retrospy/disco-cart/cartridge/PCBWay_BOM.xlsx

 |  |  | xxxx xxxx xxxxx xxPCS BOM (Sample Bill of Materials)
Item # | *Designator | *Qty | Manufacturer | *Mfg Part # | Description / Value | *Package/Footprint | Type | Your Instructions / Notes
1 | C3,C4,C5,C9,C10,C11 | 6 | KYOCERA AVX | KGM21NR71H104KM | CAP CER 0.1UF 50V X7R 0805 | 0805 | SMD
2 | C1,C8 | 2 | Samsung Electro-Mechanics | CL21B105KAFNNNE | CAP CER 1UF 25V X7R 0805 | 0805 | SMD
3 | C6 | 1 | Samsung Electro-Mechanics | CL21A106KOCLRNC | CAP CER 10UF 16V X5R 0805 | 0805 | SMD
4 | D1 | 1 | Nexperia USA Inc. | PMEG2005CT,215 | DIODE ARRAY SCHOTTKY 20V | SOT23 | SMD
5 | D2 | 1 | onsemi | MMBD717LT1G | DIODE ARRAY SCHOTTKY 20V SC70-3 | SOT-323 | SMD
6 | R1,R2,R3,R4,R5,R6,R7,R8,R9 | 9 | YAGEO | RC0805JR-0710KL | RES 10K OHM 5% 1/8W 0805 | 0805 | SMD
7 | SW2 | 1 | Nidec Components Corporation | CL-SB-13B-01T | SWITCH SLIDE SP3T 200MA 12V | SP3T | SMD
8 | U2 | 1 | Texas Instruments | SN74CBTLV3125PW | IC BUS SWITCH 1 X 1:1 14TSSOP | 14TSSOP | SMD
9 | U3 | 1 | Microchip Technology | SST39VF6401B-70-4I-EKE-T | IC FLASH 64MBIT PARALLEL 48TSOP | 48TSOP | SMD
Need a quick and accurante quote? Need an efficient production? Please read SMT Ordering Necessary Files & Info in 1 minute. Thank you very much! (https://www.pcbway.com/smt_ordering_guide.html)
Click for Instructions on How to Create a BOM (https://www.pcbway.com/blog/PCB_Assembly/How_to_Build_a_BOM__Bill_Of_Materials_.html)
