retrospy/disco-cart/cartridge/Disco-Cart-3e/Disco-Cart-3e_BOM_2024-07-28.xlsx

 |  |  | xxxx xxxx xxxxx xxPCS BOM (Sample Bill of Materials)
Item # | *Designator | *Qty | Manufacturer | *Mfg Part # | Description / Value | *Package/Footprint | Type | Your Instructions / Notes
1 | C1,C8 | 2 | Samsung Electro-Mechanics | CL21B105KAFNNNE | CAP CER 1UF 25V X7R 0805 | 0805 | SMD
2 | C2,C4,C5,C9,C10,C11 | 6 | KYOCERA AVX | KGM21NR71H104KT | CAP CER 0.1UF 50V X7R 0805 | 0805 | SMD
3 | C3,C7,C27,C28,C30,C31,C32,C33,C34,C35,C36,C40 | 12 | Murata | GRM155R71E104KE14J | CAP CER 0.1UF 25V X7R 0402 | 0402 | SMD
4 | C29,C37 | 2 | Murata | GRM155C81A105KA12D | CAP CER 1UF 10V X6S 0402 | 0402 | SMD
5 | C6,C38,C39,C41 | 4 | Murata | GRM21BR61C106KE15K | CAP CER 10UF 16V X5R 0805 | 0805 | SMD
6 | C42,C43 | 2 | Murata | GCM1555C1H150JA16D | CAP CER 15PF 50V C0G/NP0 0402 | 0402 | SMD
7 | D1 | 1 | Nexperia USA Inc. | PMEG2005CT,215 | DIODE ARR SCHOTT 20V TO236AB | SOT23 | SMD
8 | D2 | 1 | onsemi | MMBD717LT1G | DIODE ARRAY SCHOTT 20V SC70-3 | SOT-323 | SMD
9 | IC1 | 1 | Texas Instruments | SN74CBTLV3125PWR | Digital Bus Switch ICs Quad FET Low V | 14-TSSOP | SMD
10 | IC2 | 1 | Micron Technology Inc. | MT28EW01GABA1HJS-0SIT | IC FLASH 1GBIT PARALLEL 56TSOP | 56-TSOP | SMD
11 | IC4 | 1 | Raspberry Pi | SC0914 (13) | IC MCU 32BIT EXT MEM 56QFN | 56QFN | SMD
12 | IC6, IC7 | 2 | Texas Instruments | SN74HC373PWR | IC D-TYPE TRANSP SGL 8:8 20TSSOP | 20TSSOP | SMD
13 | J1 | 1 | Amphenol ICC (FCI) | 10118194-0001LF | CONN RCPT USB2.0 MICRO B SMD R/A |  | SMD
14 | R1,R2,R3,R4,R5,R6,R7,R8,R9,R10,R11,R12,R13,R14 | 14 | Stackpole Electronics Inc | RMCF0805JT10K0 | RES 10K OHM 5% 1/8W 0805 | 0805 | SMD
15 | R15, R16 | 2 | Stackpole Electronics Inc | RMCF0603ZT0R00 | RES 0 OHM JUMPER 1/10W 0603 | 0603 | SMD
16 | R17 | 1 | Yageo | RC0805FR-071KL | RES 1K OHM 1% 1/8W 0805 | 0805 | SMD
17 | R19,R22 | 2 | Yageo | RC0402FR-071KP | RES SMD 1K OHM 1% 1/16W 0402 | 0402 | SMD
18 | R20,R21 | 2 | Yageo | RC0402FR-0727R4L | RES SMD 27.4 OHM 1% 1/16W 0402 | 0402 | SMD
19 | U4 | 1 | Winbond | W25Q16JVSSIQ TR | IC FLASH 16MBIT SPI/QUAD 8SOIC | SOIC-8 | SMD
20 | U3 | 1 | ON Semiconductor | NCP1117ST33T3G | IC REG LINEAR 3.3V 1A SOT223 | SOT-223-3 | SMD
21 | Y2 | 1 | Abracon | ABM8G-12.000MHZ-4Y-T3 | CRYSTAL 12.0000MHZ 10PF SMD | SMD_3225 | SMD
Need a quick and accurante quote? Need an efficient production? Please read SMT Ordering Necessary Files & Info in 1 minute. Thank you very much! (https://www.pcbway.com/smt_ordering_guide.html)
Click for Instructions on How to Create a BOM (https://www.pcbway.com/blog/PCB_Assembly/How_to_Build_a_BOM__Bill_Of_Materials_.html)
