retrospy/disco-cart/cartridge/Disco-Cart-3e/Disco-Cart-3e-Schematic-1.pdf

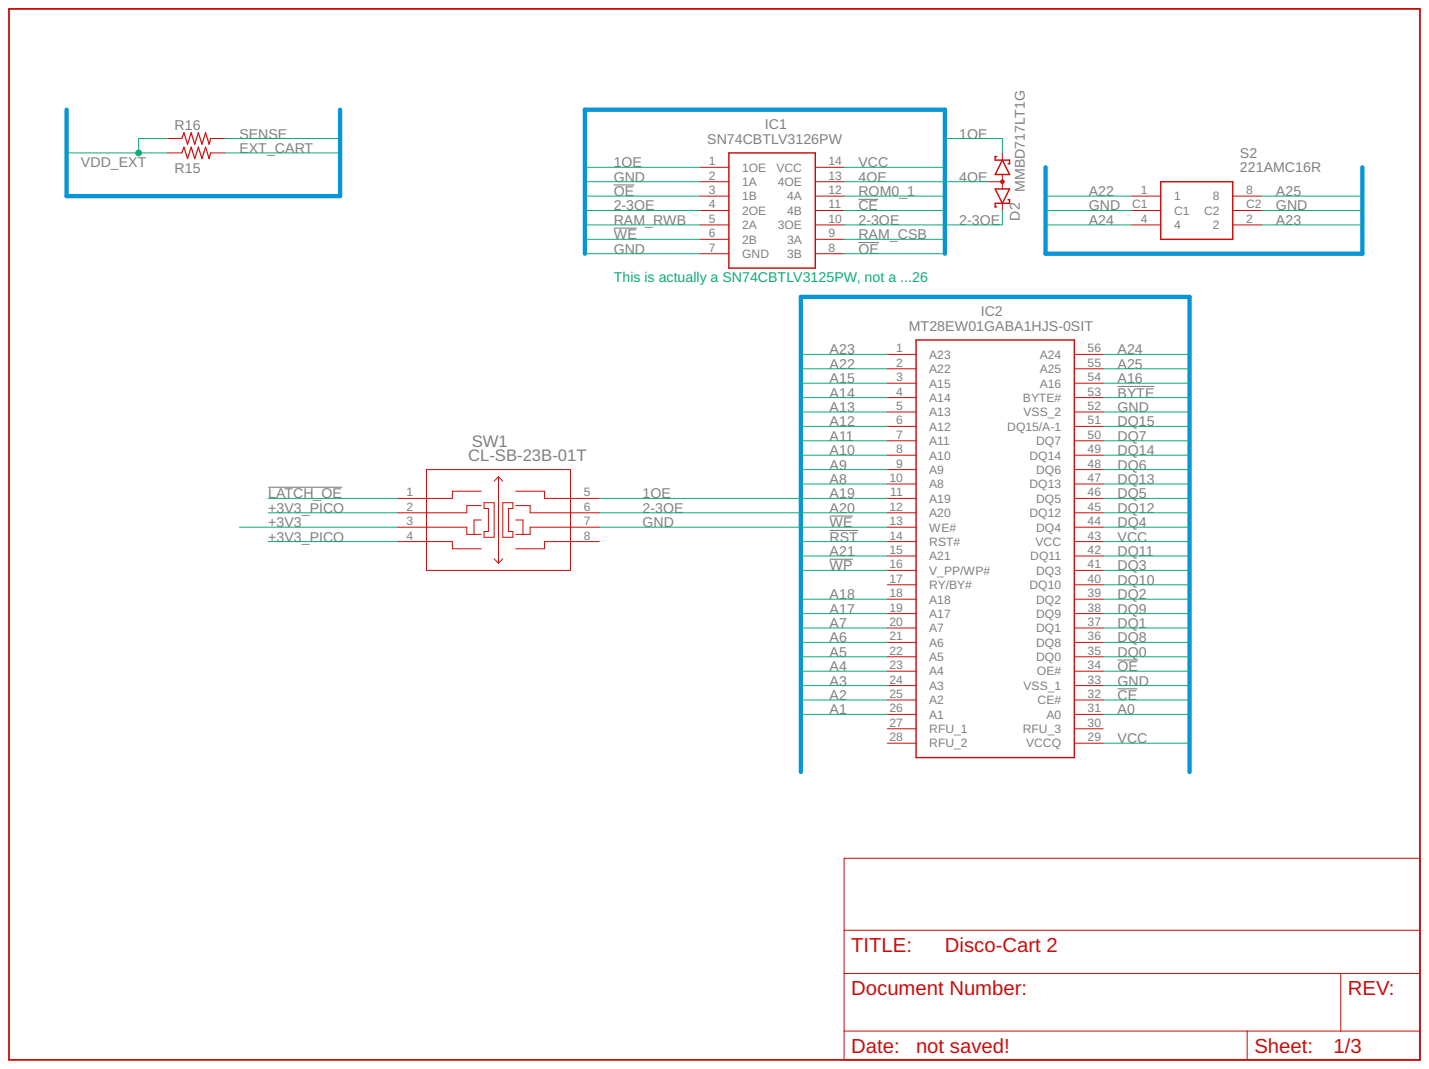
[picture p1: page 1]

This is actually a SN74CBTLV3125PW, not a ...26

A22 | 55 A16 A25
A14 | 54 BYTE# BYTE
A15 | A16
A13 | 53 VSS_2 GND
A12 | 52 DQ15/A-1 51 DQ7 DQ15

A11 | 50 DQ14 DQ7
A9 | 49 DQ6 DQ6
A10 | DQ14
A8 | 48 DQ13 DQ13
A19 A20 WE RST | 47 DQ5 46 DQ12 DQ5

A21 | 43 DQ11 DQ11
WP | 42 DQ3 41 DQ10 DQ3

A18 | 40 DQ2 DQ10
A17 | 39 DQ9 DQ9
A7 | 38 DQ1 DQ1
A6 | 37 DQ8 36 DQ0 DQ8

A5 | 35 OE# DQ0
A3 | 34 VSS_1 GND
A4 | OE
A2 | 33 CE# CE
A1 | 32 A0 31 RFU_3 A0

Document Number: | REV:

Date: not saved! | Sheet: 1/3
