retrospy/disco-cart/cartridge/Disco-Cart-3e/Disco-Cart-3e-Schematic-2.pdf

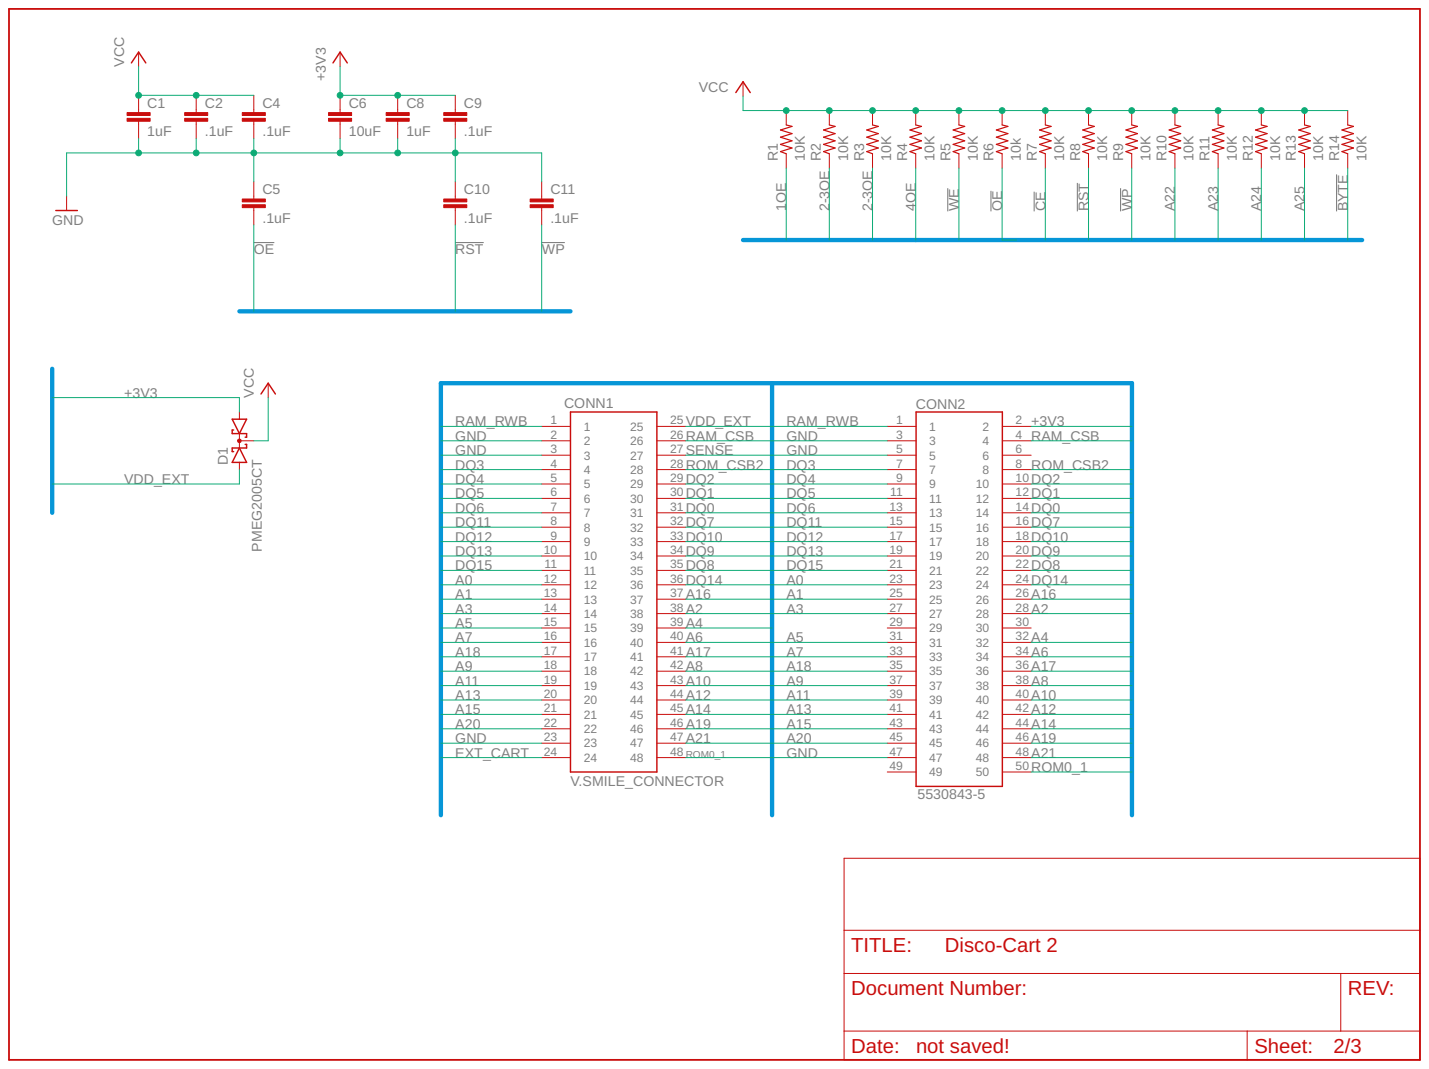
[picture p2: page 1]

GND 2 | 26 RAM_CSB | GND 3 | 4 RAM_CSB
GND 3 | 27 SENSE | GND 5 | 6 ROM_CSB2
DQ3 4 | 28 ROM_CSB2 | DQ3 7 | 8
DQ4 5 | 29 DQ2 | DQ4 9 | 10 DQ2
DQ5 6 | 30 DQ1 | DQ5 11 | 12 DQ1
DQ6 7 | 31 DQ0 | DQ6 13 | 14 DQ0
DQ11 8 | 32 DQ7 | DQ11 15 | 16 DQ7
DQ12 9 | 33 DQ10 | DQ12 17 | 18 DQ10
DQ13 10 | 34 DQ9 | DQ13 19 | 20 DQ9
DQ15 11 | 35 DQ8 | DQ15 21 | 22 DQ8
A0 12 | 36 DQ14 | A0 23 | 24 DQ14
A1 13 | 37 A16 | A1 25 | 26 A16
A3 14 | 38 A2 | A3 27 | 28 A2
A5 15 | 39 A4 | 29 A5 31 | 30 A4

A18 17 | 41 A17 | A7 33 | 34 A6
A9 18 | 42 A8 | A18 35 | 36 A17
A11 19 | 43 A10 | A9 37 | 38 A8
A13 20 | 44 A12 | A11 39 | 40 A10
A15 21 | 45 A14 | A13 41 | 42 A12
A20 22 | 46 A19 | A15 43 | 44 A14
GND 23 | 47 A21 | A20 45 | 46 A19
EXT_CART 24 | 48 | GND 47 | 48 A21

Document Number: | REV:

Date: not saved! | Sheet: 2/3
