retrospy/disco-cart/cartridge/Disco-Cart-3e/Disco-Cart-3e-Schematic-3.pdf

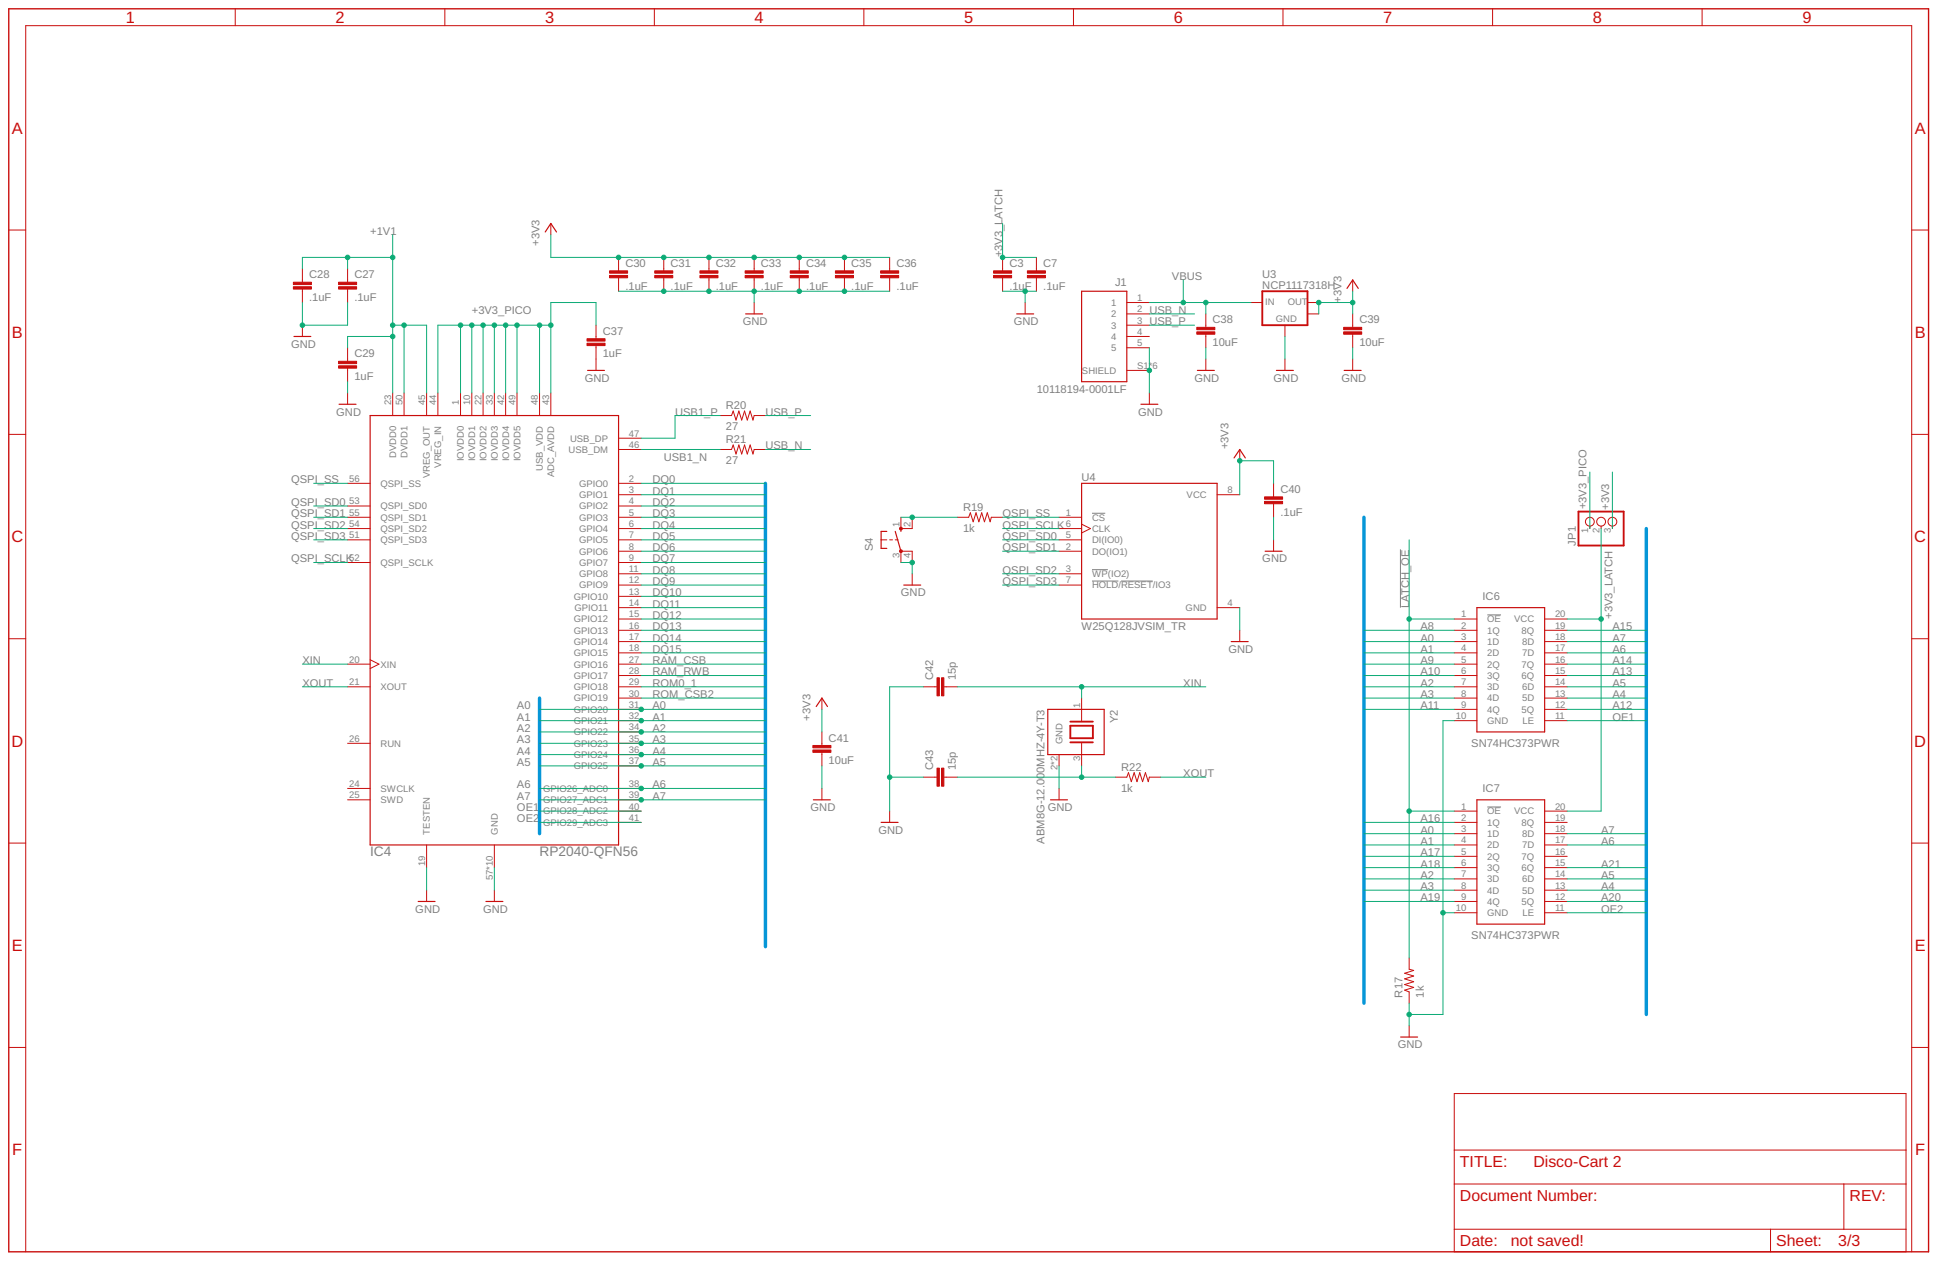
[picture p3: page 1]

36 GPIO25

37 GPIO26_ADC0 38 GPIO27_ADC1

A16 | 2 | | 19 18
A0 | 3
A1 | 4 | | 17 A6

A18 | 6
A2 | 7 | 14 A5
A3 | 8 | 13 A4

Document Number: | REV:

Date: not saved! | Sheet: 3/3
