retrospy/disco-cart/cartridge/Disco-Cart-3e/EAGLE/Disco-Cart 2.brd

## EAGLE design cartridge/Disco-Cart-3e/EAGLE/Disco-Cart 2.brd (2024-10-04)

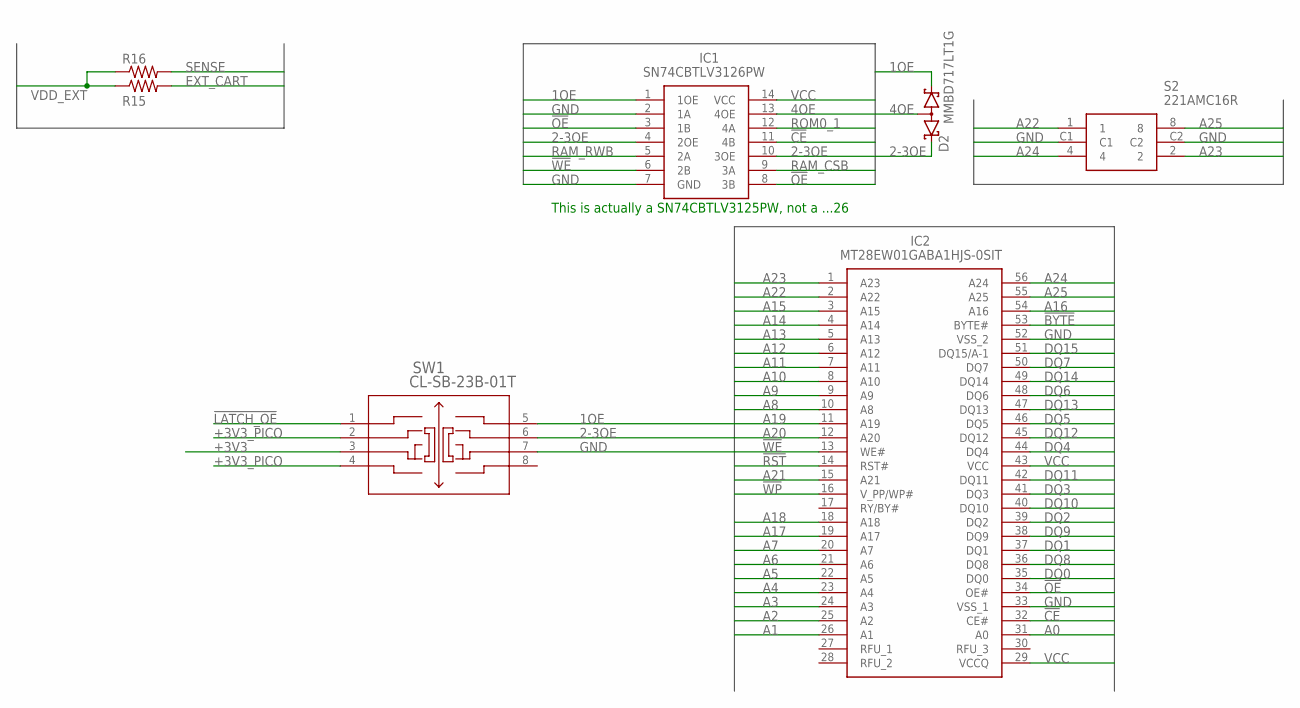
[picture p4: schematic Disco-Cart 2.sch, sheet 1]

Parts:
D2: MMBD717LT1G; SOT65P220X100-3N
IC1: SN74CBTLV3126PW; SOP65P640X120-14N
IC2: MT28EW01GABA1HJS-0SIT; SOP50P2000X120-56N
R15, R16: R-US_R0603; R0603
S2: 221AMC16R
SW1: CL-SB-23B-01T; CL-SB-23B_NDC

Connections:
1OE: D2.1 (K2), IC1.1 (1OE), SW1.5 (8); also elsewhere on the board
2-3OE: D2.2 (K1), IC1.4 (2OE), IC1.10 (3OE), SW1.6 (7); also elsewhere on the board
4OE: D2.3 (AA), IC1.13 (4OE); also elsewhere on the board
!BYTE: IC2.53 (BYTE#); also elsewhere on the board
!CE: IC1.11 (4B), IC2.32 (CE#); also elsewhere on the board
!LATCH_OE: SW1.1; also elsewhere on the board
!OE: IC1.3 (1B), IC1.8 (3B), IC2.34 (OE#); also elsewhere on the board
!RST: IC2.14 (RST#); also elsewhere on the board
!WE: IC1.6 (2B), IC2.13 (WE#); also elsewhere on the board
!WP: IC2.16 (V_PP/WP#); also elsewhere on the board
+3V3: SW1.3; also elsewhere on the board
+3V3_PICO: SW1.2, SW1.4; also elsewhere on the board
A0: IC2.31 (A0); also elsewhere on the board
A1: IC2.26 (A1); also elsewhere on the board
A2: IC2.25 (A2); also elsewhere on the board
A3: IC2.24 (A3); also elsewhere on the board
A4: IC2.23 (A4); also elsewhere on the board
A5: IC2.22 (A5); also elsewhere on the board
A6: IC2.21 (A6); also elsewhere on the board
A7: IC2.20 (A7); also elsewhere on the board
A8: IC2.10 (A8); also elsewhere on the board
A9: IC2.9 (A9); also elsewhere on the board
A10: IC2.8 (A10); also elsewhere on the board
A11: IC2.7 (A11); also elsewhere on the board
A12: IC2.6 (A12); also elsewhere on the board
A13: IC2.5 (A13); also elsewhere on the board
A14: IC2.4 (A14); also elsewhere on the board
A15: IC2.3 (A15); also elsewhere on the board
A16: IC2.54 (A16); also elsewhere on the board
A17: IC2.19 (A17); also elsewhere on the board
A18: IC2.18 (A18); also elsewhere on the board
A19: IC2.11 (A19); also elsewhere on the board
A20: IC2.12 (A20); also elsewhere on the board
A21: IC2.15 (A21); also elsewhere on the board
A22: IC2.2 (A22), S2.1; also elsewhere on the board
A23: IC2.1 (A23), S2.2; also elsewhere on the board
A24: IC2.56 (A24), S2.4; also elsewhere on the board
A25: IC2.55 (A25), S2.8; also elsewhere on the board
DQ0: IC2.35 (DQ0); also elsewhere on the board
DQ1: IC2.37 (DQ1); also elsewhere on the board
DQ2: IC2.39 (DQ2); also elsewhere on the board
DQ3: IC2.41 (DQ3); also elsewhere on the board
DQ4: IC2.44 (DQ4); also elsewhere on the board
DQ5: IC2.46 (DQ5); also elsewhere on the board
DQ6: IC2.48 (DQ6); also elsewhere on the board
DQ7: IC2.50 (DQ7); also elsewhere on the board
DQ8: IC2.36 (DQ8); also elsewhere on the board
DQ9: IC2.38 (DQ9); also elsewhere on the board
DQ10: IC2.40 (DQ10); also elsewhere on the board
DQ11: IC2.42 (DQ11); also elsewhere on the board
DQ12: IC2.45 (DQ12); also elsewhere on the board
DQ13: IC2.47 (DQ13); also elsewhere on the board
DQ14: IC2.49 (DQ14); also elsewhere on the board
DQ15: IC2.51 (DQ15/A-1); also elsewhere on the board
EXT_CART: R15.2; also elsewhere on the board
GND: IC1.2 (1A), IC1.7 (GND), IC2.33 (VSS_1), IC2.52 (VSS_2), S2.C1, S2.C2, SW1.7 (6); also elsewhere on the board
RAM_CSB: IC1.9 (3A); also elsewhere on the board
RAM_RWB: IC1.5 (2A); also elsewhere on the board
ROM0_1: IC1.12 (4A); also elsewhere on the board
SENSE: R16.2; also elsewhere on the board
VCC: IC1.14 (VCC), IC2.29 (VCCQ), IC2.43 (VCC); also elsewhere on the board
VDD_EXT: R15.1, R16.1; also elsewhere on the board

Notes on the sheet:
This is actually a SN74CBTLV3125PW, not a ...26

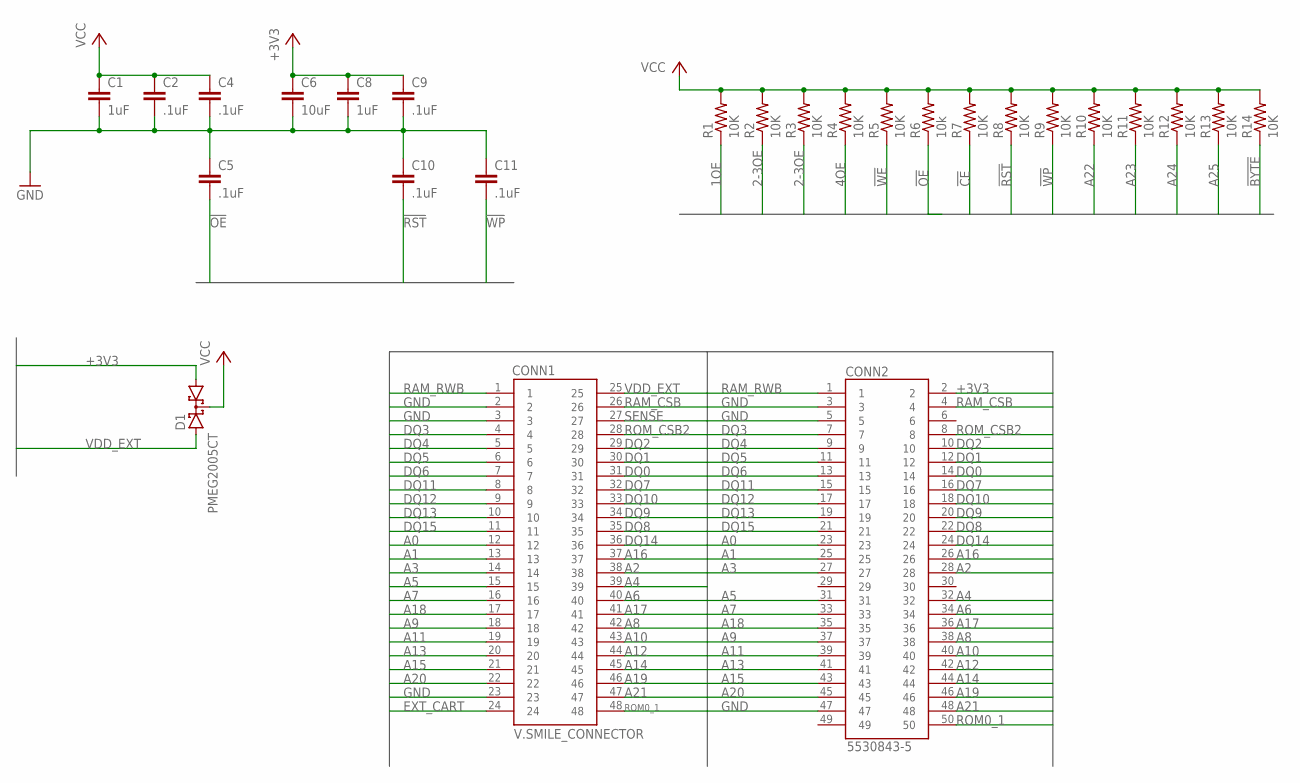
[picture p5: schematic Disco-Cart 2.sch, sheet 2]

Parts:
C1, C8: 1uF; C0805
C2, C4, C5, C9, C10, C11: .1uF; C0805
C6: 10uF; C0805
CONN1: V.SMILE_CONNECTOR
CONN2: 5530843-5; TE_5530843-5
D1: PMEG2005CT; SOT23
R1, R2, R3, R4, R5, R7, R8, R9, R10, R11, R12, R13, R14: 10K; M0805
R6: 10k; M0805

Connections:
1OE: R1.1; also elsewhere on the board
2-3OE: R2.1, R3.1; also elsewhere on the board
4OE: R4.1; also elsewhere on the board
!BYTE: R14.1; also elsewhere on the board
!CE: R7.1; also elsewhere on the board
!OE: C5.2, R6.1; also elsewhere on the board
!RST: C10.2, R8.1; also elsewhere on the board
!WE: R5.1; also elsewhere on the board
!WP: C11.2, R9.1; also elsewhere on the board
+3V3: C6.1, C8.1, C9.1, CONN2.2, D1.1 (A1); also elsewhere on the board
A0: CONN1.12, CONN2.23; also elsewhere on the board
A1: CONN1.13, CONN2.25; also elsewhere on the board
A2: CONN1.38, CONN2.28; also elsewhere on the board
A3: CONN1.14, CONN2.27; also elsewhere on the board
A4: CONN1.39, CONN2.32; also elsewhere on the board
A5: CONN1.15, CONN2.31; also elsewhere on the board
A6: CONN1.40, CONN2.34; also elsewhere on the board
A7: CONN1.16, CONN2.33; also elsewhere on the board
A8: CONN1.42, CONN2.38; also elsewhere on the board
A9: CONN1.18, CONN2.37; also elsewhere on the board
A10: CONN1.43, CONN2.40; also elsewhere on the board
A11: CONN1.19, CONN2.39; also elsewhere on the board
A12: CONN1.44, CONN2.42; also elsewhere on the board
A13: CONN1.20, CONN2.41; also elsewhere on the board
A14: CONN1.45, CONN2.44; also elsewhere on the board
A15: CONN1.21, CONN2.43; also elsewhere on the board
A16: CONN1.37, CONN2.26; also elsewhere on the board
A17: CONN1.41, CONN2.36; also elsewhere on the board
A18: CONN1.17, CONN2.35; also elsewhere on the board
A19: CONN1.46, CONN2.46; also elsewhere on the board
A20: CONN1.22, CONN2.45; also elsewhere on the board
A21: CONN1.47, CONN2.48; also elsewhere on the board
A22: R10.1; also elsewhere on the board
A23: R11.1; also elsewhere on the board
A24: R12.1; also elsewhere on the board
A25: R13.1; also elsewhere on the board
DQ0: CONN1.31, CONN2.14; also elsewhere on the board
DQ1: CONN1.30, CONN2.12; also elsewhere on the board
DQ2: CONN1.29, CONN2.10; also elsewhere on the board
DQ3: CONN1.4, CONN2.7; also elsewhere on the board
DQ4: CONN1.5, CONN2.9; also elsewhere on the board
DQ5: CONN1.6, CONN2.11; also elsewhere on the board
DQ6: CONN1.7, CONN2.13; also elsewhere on the board
DQ7: CONN1.32, CONN2.16; also elsewhere on the board
DQ8: CONN1.35, CONN2.22; also elsewhere on the board
DQ9: CONN1.34, CONN2.20; also elsewhere on the board
DQ10: CONN1.33, CONN2.18; also elsewhere on the board
DQ11: CONN1.8, CONN2.15; also elsewhere on the board
DQ12: CONN1.9, CONN2.17; also elsewhere on the board
DQ13: CONN1.10, CONN2.19; also elsewhere on the board
DQ14: CONN1.36, CONN2.24; also elsewhere on the board
DQ15: CONN1.11, CONN2.21; also elsewhere on the board
EXT_CART: CONN1.24; also elsewhere on the board
GND: C1.2, C2.2, C4.2, C5.1, C6.2, C8.2, C9.2, C10.1, C11.1, CONN1.2, CONN1.3, CONN1.23, CONN2.3, CONN2.5, CONN2.47; also elsewhere on the board
RAM_CSB: CONN1.26, CONN2.4; also elsewhere on the board
RAM_RWB: CONN1.1, CONN2.1; also elsewhere on the board
ROM0_1: CONN1.48, CONN2.50; also elsewhere on the board
ROM_CSB2: CONN1.28, CONN2.8; also elsewhere on the board
SENSE: CONN1.27; also elsewhere on the board
VCC: C1.1, C2.1, C4.1, D1.3 (C), R1.2, R2.2, R3.2, R4.2, R5.2, R6.2, R7.2, R8.2, R9.2, R10.2, R11.2, R12.2, R13.2, R14.2; also elsewhere on the board
VDD_EXT: CONN1.25, D1.2 (A2); also elsewhere on the board

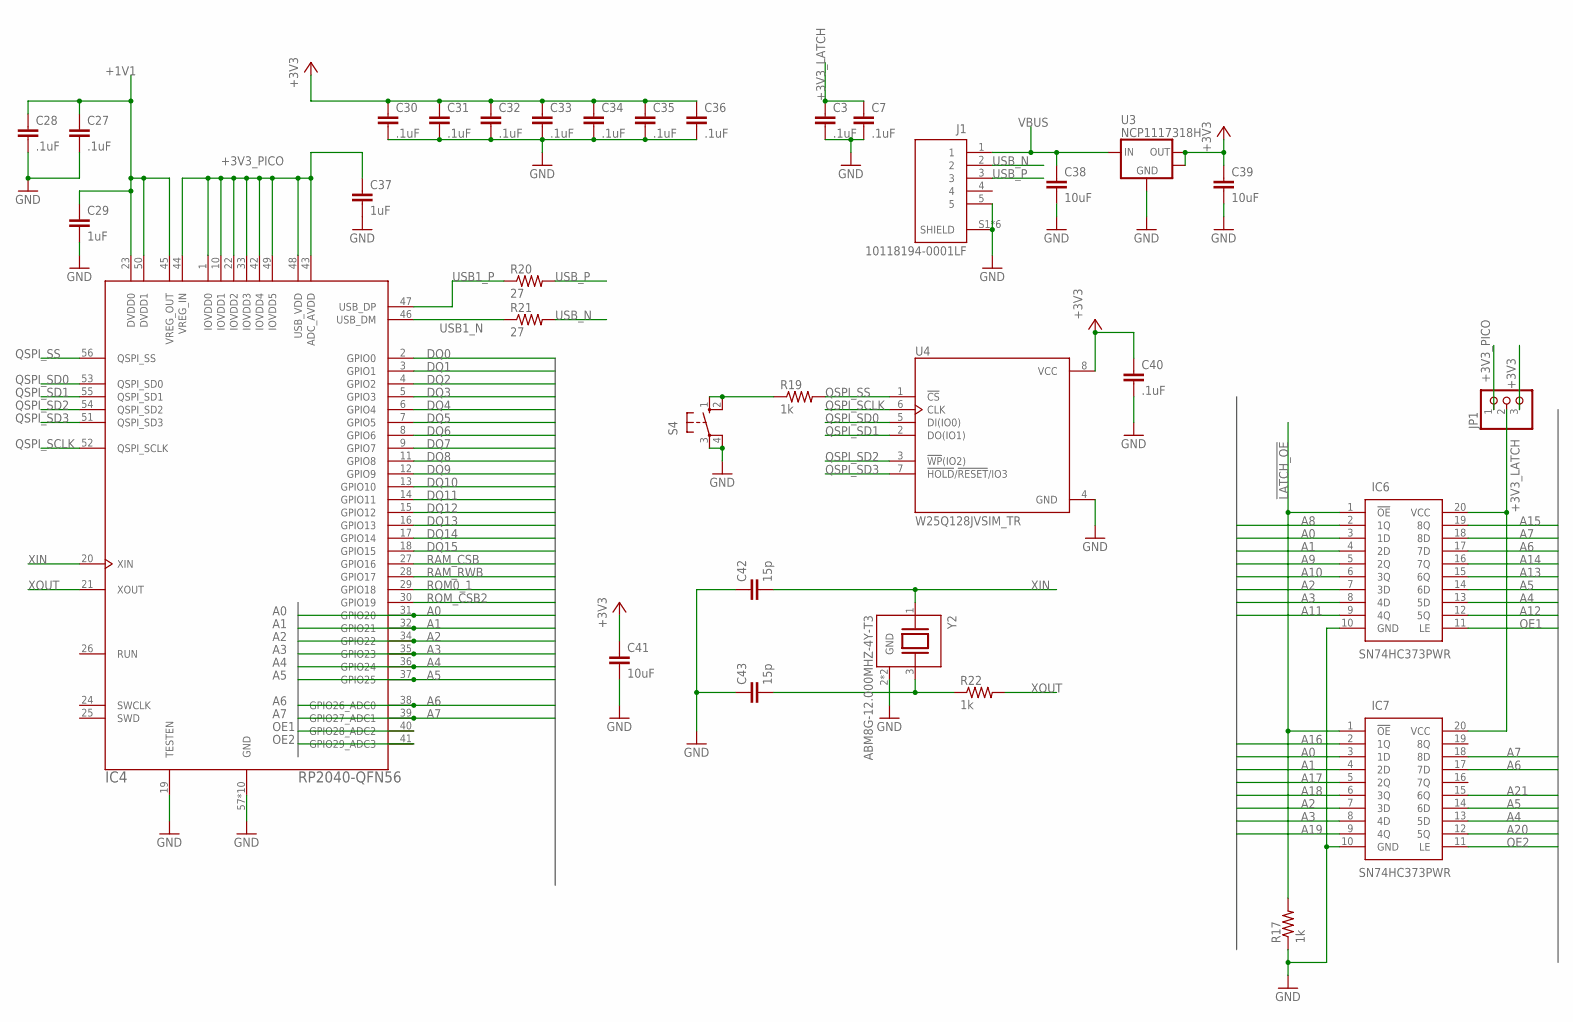
[picture p6: schematic Disco-Cart 2.sch, sheet 3]

Parts:
C3, C7, C27, C28, C30, C31, C32, C33, C34, C35, C36, C40: .1uF; C0402
C29, C37: 1uF; C0402
C38, C39, C41: 10uF; C0805
C42, C43: 15p; C0402
IC4: RP2040-QFN56; RP2040-QFN-56
IC6, IC7: SN74HC373PWR; SOP65P640X120-20N
J1: 10118194-0001LF; AMPHENOL_10118194-0001LF
JP1: PINHD-1X3; 1X03
R17: 1k; R0805
R19, R22: 1k; R0402
R20, R21: 27; R0402
S4: 10-XX; B3F-10XX
U3: NCP1117318H; SOT223
U4: W25Q128JVSIM_TR; SOIC127P790X216-8N
Y2: ABM8G-12.000MHZ-4Y-T3; XTAL_ABM8G-12.000MHZ-4Y-T3

Connections:
!LATCH_OE: IC6.1 (!OE), IC7.1 (!OE), R17.2; also elsewhere on the board
+1V1: C27.1, C28.1, C29.1, IC4.23 (DVDD0), IC4.45 (VREG_OUT), IC4.50 (DVDD1)
+3V3: C30.1, C31.1, C32.1, C33.1, C34.1, C35.1, C36.1, C39.1, C40.1, C41.1, JP1.3, U3.2 (OUT), U3.TAB (OUT), U4.8 (VCC); also elsewhere on the board
+3V3_LATCH: C3.1, C7.1, IC6.20 (VCC), IC7.20 (VCC), JP1.2
+3V3_PICO: C37.1, IC4.1 (IOVDD0), IC4.10 (IOVDD1), IC4.22 (IOVDD2), IC4.33 (IOVDD3), IC4.42 (IOVDD4), IC4.43 (ADC_AVDD), IC4.44 (VREG_IN), IC4.48 (USB_VDD), IC4.49 (IOVDD5), JP1.1; also elsewhere on the board
A0: IC4.31 (GPIO20), IC6.3 (1D), IC7.3 (1D); also elsewhere on the board
A1: IC4.32 (GPIO21), IC6.4 (2D), IC7.4 (2D); also elsewhere on the board
A2: IC4.34 (GPIO22), IC6.7 (3D), IC7.7 (3D); also elsewhere on the board
A3: IC4.35 (GPIO23), IC6.8 (4D), IC7.8 (4D); also elsewhere on the board
A4: IC4.36 (GPIO24), IC6.13 (5D), IC7.13 (5D); also elsewhere on the board
A5: IC4.37 (GPIO25), IC6.14 (6D), IC7.14 (6D); also elsewhere on the board
A6: IC4.38 (GPIO26_ADC0), IC6.17 (7D), IC7.17 (7D); also elsewhere on the board
A7: IC4.39 (GPIO27_ADC1), IC6.18 (8D), IC7.18 (8D); also elsewhere on the board
A8: IC6.2 (1Q); also elsewhere on the board
A9: IC6.5 (2Q); also elsewhere on the board
A10: IC6.6 (3Q); also elsewhere on the board
A11: IC6.9 (4Q); also elsewhere on the board
A12: IC6.12 (5Q); also elsewhere on the board
A13: IC6.15 (6Q); also elsewhere on the board
A14: IC6.16 (7Q); also elsewhere on the board
A15: IC6.19 (8Q); also elsewhere on the board
A16: IC7.2 (1Q); also elsewhere on the board
A17: IC7.5 (2Q); also elsewhere on the board
A18: IC7.6 (3Q); also elsewhere on the board
A19: IC7.9 (4Q); also elsewhere on the board
A20: IC7.12 (5Q); also elsewhere on the board
A21: IC7.15 (6Q); also elsewhere on the board
DQ0: IC4.2 (GPIO0); also elsewhere on the board
DQ1: IC4.3 (GPIO1); also elsewhere on the board
DQ2: IC4.4 (GPIO2); also elsewhere on the board
DQ3: IC4.5 (GPIO3); also elsewhere on the board
DQ4: IC4.6 (GPIO4); also elsewhere on the board
DQ5: IC4.7 (GPIO5); also elsewhere on the board
DQ6: IC4.8 (GPIO6); also elsewhere on the board
DQ7: IC4.9 (GPIO7); also elsewhere on the board
DQ8: IC4.11 (GPIO8); also elsewhere on the board
DQ9: IC4.12 (GPIO9); also elsewhere on the board
DQ10: IC4.13 (GPIO10); also elsewhere on the board
DQ11: IC4.14 (GPIO11); also elsewhere on the board
DQ12: IC4.15 (GPIO12); also elsewhere on the board
DQ13: IC4.16 (GPIO13); also elsewhere on the board
DQ14: IC4.17 (GPIO14); also elsewhere on the board
DQ15: IC4.18 (GPIO15); also elsewhere on the board
GND: C3.2, C7.2, C27.2, C28.2, C29.2, C30.2, C31.2, C32.2, C33.2, C34.2, C35.2, C36.2, C37.2, C38.2, C39.2, C40.2, C41.2, C42.1, C43.1, IC4.19 (TESTEN), IC4.57 (GND), IC4.58 (GND), IC4.59 (GND), IC4.60 (GND), IC4.61 (GND), IC4.62 (GND), IC4.63 (GND), IC4.64 (GND), IC4.65 (GND), IC4.66 (GND), IC6.10 (GND), IC7.10 (GND), J1.5, J1.S1 (SHIELD), J1.S2 (SHIELD), J1.S3 (SHIELD), J1.S4 (SHIELD), J1.S5 (SHIELD), J1.S6 (SHIELD), R17.1, S4.3, S4.4 (P1), U3.1 (GND), U4.4 (GND), Y2.2 (GND), Y2.4 (GND); also elsewhere on the board
unnamed: R19.1, S4.1 (S), S4.2 (S1)
OE1: IC4.40 (GPIO28_ADC2), IC6.11 (LE)
OE2: IC4.41 (GPIO29_ADC3), IC7.11 (LE)
QSPI_SCLK: IC4.52 (QSPI_SCLK), U4.6 (CLK)
QSPI_SD0: IC4.53 (QSPI_SD0), U4.5 (DI(IO0))
QSPI_SD1: IC4.55 (QSPI_SD1), U4.2 (DO(IO1))
QSPI_SD2: IC4.54 (QSPI_SD2), U4.3 (!WP!(IO2))
QSPI_SD3: IC4.51 (QSPI_SD3), U4.7 (!HOLD!/!RESET!/IO3)
QSPI_SS: IC4.56 (QSPI_SS), R19.2, U4.1 (!CS)
RAM_CSB: IC4.27 (GPIO16); also elsewhere on the board
RAM_RWB: IC4.28 (GPIO17); also elsewhere on the board
ROM0_1: IC4.29 (GPIO18); also elsewhere on the board
ROM_CSB2: IC4.30 (GPIO19); also elsewhere on the board
USB1_N: IC4.46 (USB_DM), R21.1
USB1_P: IC4.47 (USB_DP), R20.1
USB_N: J1.2, R21.2
USB_P: J1.3, R20.2
VBUS: C38.1, J1.1, U3.3 (IN)
XIN: C42.2, IC4.20 (XIN), Y2.1
XOUT: IC4.21 (XOUT), R22.2
XOUT2: C43.2, R22.1, Y2.3 (2)

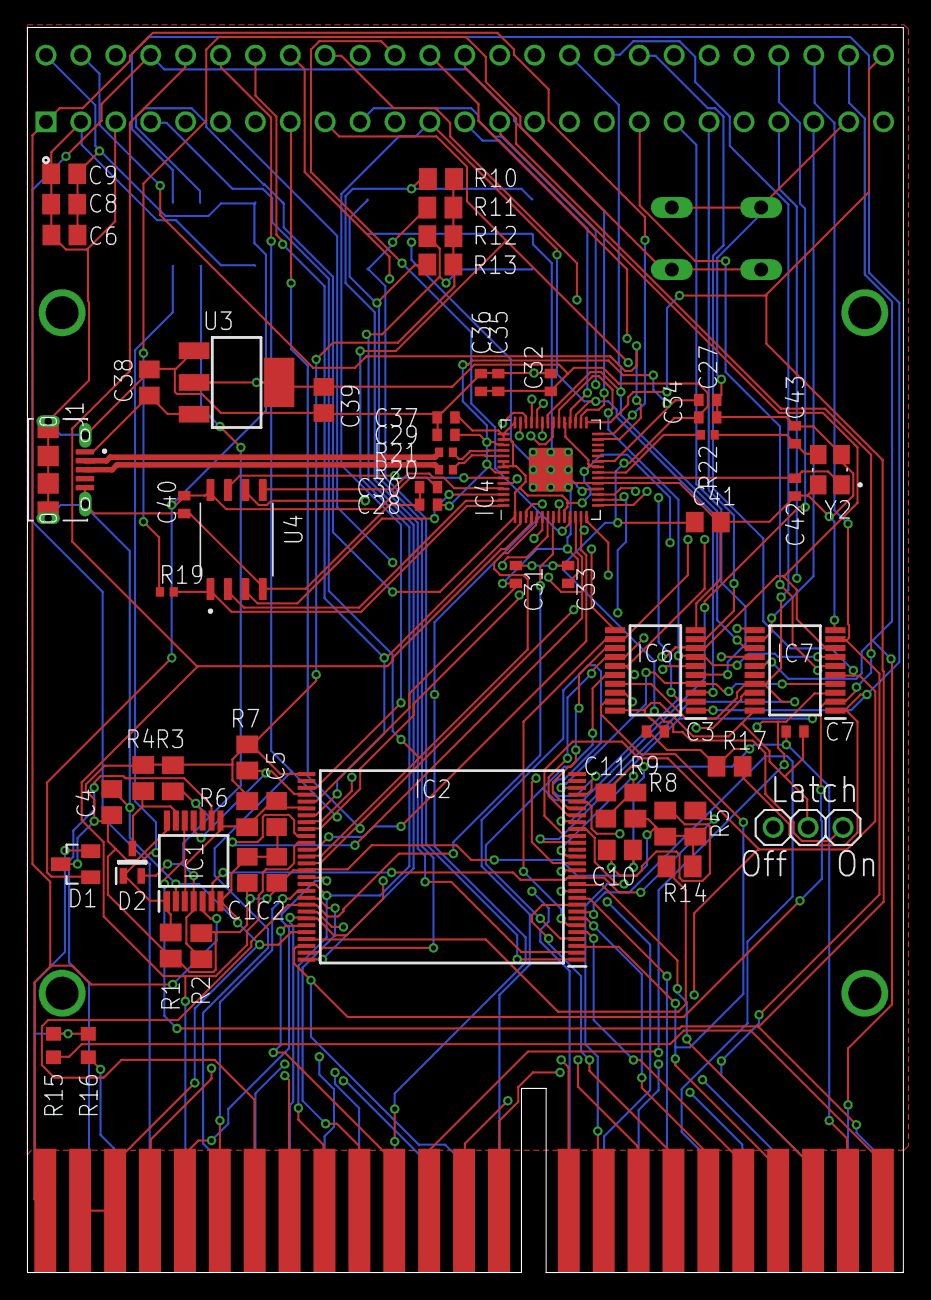
[picture p7: board Disco-Cart 2.brd from above]

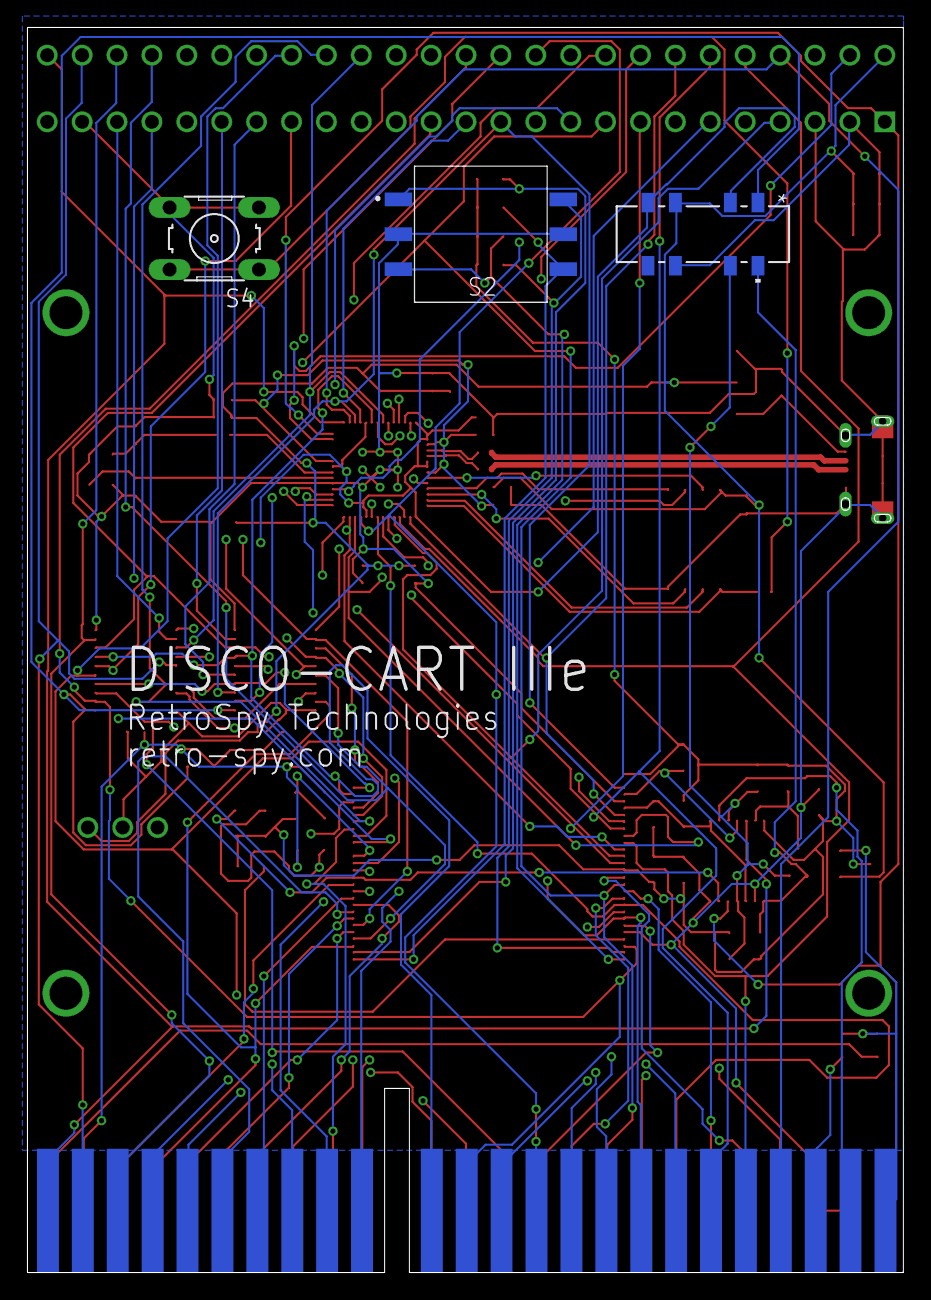
[picture p8: board Disco-Cart 2.brd from below]

Board: 4 copper layers, 63.7 x 90.6 mm, 66 parts (3 on the bottom side), 82 nets.
