retrospy/disco-cart/(commit log)

2023-09-15 Added BOM and centroid file
    [PCBWay_BOM.xlsx]
2024-10-04 Uploading cartridge hardware files
    [Disco-Cart 2.brd, Disco-Cart 2.sch, Disco-Cart-3e_BOM_2024-07-28.xlsx]
2025-01-15 Added simple tester and "fixed" not waiting long enough after an ERS operation
    [firmware.ino, main.h]
